QUTstevenbulmer/Unit_EGB220/PCB/ESP32_MotorDriver/ESP32_MotorDriver.png

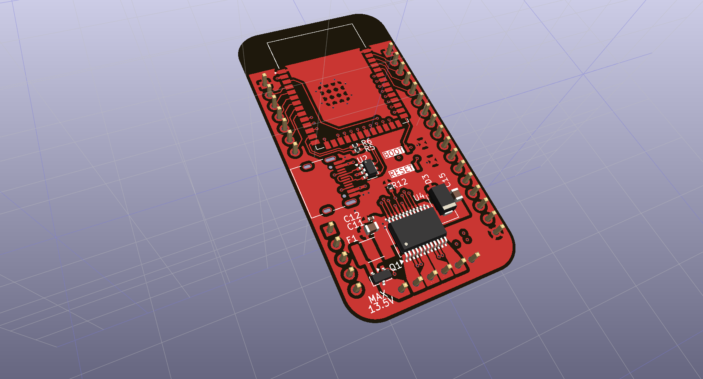
PCB/ESP32_MotorDriver/ESP32_MotorDriver.png
