QUTstevenbulmer/Unit_EGB220/PCB/ESP32_MotorDriver_BOB/ESP32_MotorDriver_BOB.png

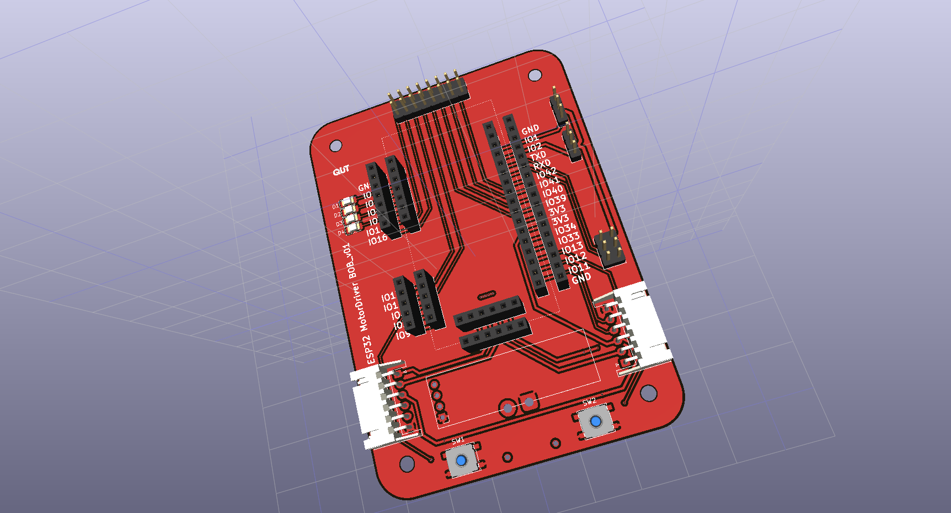
PCB/ESP32_MotorDriver_BOB/ESP32_MotorDriver_BOB.png
