QUTstevenbulmer/Unit_EGB220/PCB/ESP32_MotorDriver/production/bom.csv

Designator | Footprint | Quantity | Value | LCSC Part #
C1, C15, C5, C7 | 0805 | 4 | 10uF
C10, C9 | 0805 | 2 | 22uF
C11 | 0805 | 1 | 10uF | C3902158
C12, C13 | 0402 | 2 | 100nF | C105882
C14, C2, C6, C8 | 0402 | 4 | 100nF
C3 | 0805 | 1 | 10uF | C15850
C4 | 0402 | 1 | 100nF | C15850
D1, D2 | D_SOD-323F | 2 | SS14HE
D3 | D_SMA | 1 | SMAJ12A
F1 | 1812 | 1 | Polyfuse 3A
F2 | 0805 | 1 | Polyfuse 500mA
J1 | USB_C_Receptacle_HRO_TYPE-C-31-M-12 | 1 | USB_C_Receptacle_USB2.0 | C165948
J2 | PinHeader_1x06_P2.54mm_Vertical | 1 | Conn_01x06
J4 | PinHeader_1x05_P2.54mm_Vertical | 1 | Conn_01x05
J6 | PinHeader_1x07_P2.54mm_Vertical | 1 | Conn_01x07
J7 | PinHeader_1x17_P2.54mm_Vertical | 1 | Conn_01x17
L1 | 1008 | 1 | 4.7uH
Q1 | SOT-23 | 1 | AO3407A
R1, R2 | 0402 | 2 | 5k1
R11, R12 | 0402 | 2 | 10k | C851816
R3, R4 | 0402 | 2 | 10k | C100047
R5, R6 | 0402 | 2 | 22R
SW1 | Switch SMD STO | 1 | RESET
SW2 | Switch SMD STO | 1 | BOOT
U1 | XCVR_ESP32-S2-SOLO-N4 | 1 | ESP32-S2-SOLO-N4
U2 | SOT-23-6 | 1 | USBLC6-2SC6
U4 | SSOP-24_5.3x8.2mm_P0.65mm | 1 | TB6612FNG | C141517
U5 | TSOT-23-6 | 1 | AP63203WU
