QUTstevenbulmer/Unit_EGB220/PCB/ESP32_MotorDriver_BOB/production/bom.csv

Designator | Footprint | Quantity | Value | LCSC Part #
C11, C13, C14 | 0402 | 3 | 10uF | C3902158
C12, C15, C16 | 0402 | 3 | 100nF | C105882
D1 | 1206 | 1 | RED
D2 | 1206 | 1 | GREEN
D3 | 1206 | 1 | BLUE
D4 | 1206 | 1 | YELLOW
F1 | 0805 | 1 | Polyfuse 4A | C22368431
J1, J10 | PinSocket_1x07_P2.54mm_Vertical | 2 | Conn_01x07
J11, J2 | PinSocket_1x05_P2.54mm_Vertical | 2 | Conn_01x05
J12, J4 | PinSocket_1x06_P2.54mm_Vertical | 2 | Conn_01x06
J13, J3 | PinSocket_1x17_P2.54mm_Vertical | 2 | Conn_01x17
J14 | PinHeader_2x03_P2.54mm_Vertical | 1 | Conn_02x03_Odd_Even
J15 | PinHeader_2x08_P2.54mm_Vertical | 1 | Conn_02x08_Odd_Even
J5, J6 | JST_XH_S6B-XH-A_1x06_P2.50mm_Horizontal | 2 | Conn_01x06
J7 | AMASS_XT30PW-M_1x02_P2.50mm_Horizontal | 1 | XT30 | C431092
J8, J9 | PinHeader_1x03_P2.54mm_Vertical | 2 | Conn_01x03
Q1 | SOT-23F_TOS | 1 | SSM3J338R_LF | C146352
R1, R2, R3, R4 | 0402 | 4 | 150R
R10 | 0402 | 1 | 10k | C851816
R11, R12, R13, R14 | 0402 | 4 | 10k
R5 | 0402 | 1 | 100k
R6, R7, R8, R9 | 0402 | 4 | 4k7
SW1, SW2 | SW_SPST_EVQP0 | 2 | SW_Push
U1 | SOT-223-3_TabPin2 | 1 | LDL1117S50R
U2 | ER_OLEDM0.91_1x-I2C | 1 | ER_OLEDM0.91_1x-I2C
U3 | SO-8_3.9x4.9mm_P1.27mm | 1 | PCA9306D
U4 | logo_QUT | 1 | ESP32 MotorDriver BOB_v01
