QUTstevenbulmer/Unit_EGB220/PCB/ESP32_MotorDriver_BOB/pcbway_production/2026-10-20-12-05-17/ESP32_MotorDriver_BOB.kicad_pcb_bom.csv

Designator | Quantity | Value | Footprint | Package | MPN | DNP | Mount_Type | Description | KiLib_Generator | LCSC PN | PN_LCSC | PN_Digikey | Manufacturer | PN_Manufacturer | Sim.Pins | MANUFACTURER | LCSC Part #
C11, C13, C14 | 3 | 10uF | C_0805_2012Metric_Pad1.18x1.45mm_HandSolder |  |  |  | smt | Unpolarized capacitor | SMD_2terminal_chip_molded | C3902158
C12, C15, C16, C18, C19, C20 | 6 | 100nF | C_0402_1005Metric_Pad0.74x0.62mm_HandSolder |  |  |  | smt | Unpolarized capacitor | SMD_2terminal_chip_molded | C105882 | C105882 | 311-3342-1-ND | YAGEO | CC0402KRX5R9BB104
C17 | 1 | 10uF 25V | C_0805_2012Metric_Pad1.18x1.45mm_HandSolder |  |  |  | smt | Unpolarized capacitor | SMD_2terminal_chip_molded | C3902158
C3 | 1 | 100nF | C_0603_1608Metric_Pad1.08x0.95mm_HandSolder |  |  |  | smt | Unpolarized capacitor | SMD_2terminal_chip_molded
D1 | 1 | RED | LED_1206_3216Metric_Pad1.42x1.75mm_HandSolder |  |  |  | smt | Light emitting diode | SMD_2terminal_chip_molded |  |  |  |  |  | 1=K 2=A
D2 | 1 | GREEN | LED_1206_3216Metric_Pad1.42x1.75mm_HandSolder |  |  |  | smt | Light emitting diode | SMD_2terminal_chip_molded |  |  |  |  |  | 1=K 2=A
D3 | 1 | BLUE | LED_1206_3216Metric_Pad1.42x1.75mm_HandSolder |  |  |  | smt | Light emitting diode | SMD_2terminal_chip_molded |  |  |  |  |  | 1=K 2=A
D4 | 1 | YELLOW | LED_1206_3216Metric_Pad1.42x1.75mm_HandSolder |  |  |  | smt | Light emitting diode | SMD_2terminal_chip_molded |  |  |  |  |  | 1=K 2=A
D5 | 1 | POWER | LED_0805_2012Metric_Pad1.15x1.40mm_HandSolder |  |  |  | smt | Light emitting diode | SMD_2terminal_chip_molded |  |  |  |  |  | 1=K 2=A
D6 | 1 | BAT54J | D_SOD-323F |  |  |  | smt | 30V 200mA Schottky diode, SOD-323F
F1 | 1 | PTC RESET FUSE 16V 2.5A 1812 | Fuse_1812_4532Metric_Pad1.30x3.40mm_HandSolder |  |  |  | smt |  | SMD_2terminal_chip_molded |  |  | MF-MSMF250/16X-2CT-ND | Bourns Inc. | MF-MSMF250/16X-2
J1, J10 | 2 | Conn_01x07 | PinSocket_1x07_P2.54mm_Vertical |  |  |  | tht | Generic connector, single row, 01x07, script generated (kicad-library-utils/schlib/autogen/connector/) | connector/pin_header_socket
J11, J2 | 2 | Conn_01x05 | PinSocket_1x05_P2.54mm_Vertical |  |  |  | tht | Generic connector, single row, 01x05, script generated (kicad-library-utils/schlib/autogen/connector/) | connector/pin_header_socket
J12, J4 | 2 | Conn_01x06 | PinSocket_1x06_P2.54mm_Vertical |  |  |  | tht | Generic connector, single row, 01x06, script generated (kicad-library-utils/schlib/autogen/connector/) | connector/pin_header_socket
J13, J3 | 2 | Conn_01x17 | PinSocket_1x17_P2.54mm_Vertical |  |  |  | tht | Generic connector, single row, 01x17, script generated (kicad-library-utils/schlib/autogen/connector/) | connector/pin_header_socket
J14 | 1 | Conn_02x03_Odd_Even | PinHeader_2x03_P2.54mm_Vertical |  |  |  | tht | Generic connector, double row, 02x03, odd/even pin numbering scheme (row 1 odd numbers, row 2 even numbers), script generated (kicad-library-utils/schlib/autogen/connector/) | connector/pin_header_socket
J15 | 1 | Conn_02x08_Odd_Even | PinHeader_2x08_P2.54mm_Vertical |  |  |  | tht | Generic connector, double row, 02x08, odd/even pin numbering scheme (row 1 odd numbers, row 2 even numbers), script generated (kicad-library-utils/schlib/autogen/connector/) | connector/pin_header_socket
J5, J6 | 2 | Conn_01x06 | JST_ZH_S6B-ZR-SM4A-TF_1x06-1MP_P1.50mm_Horizontal |  |  |  | smt | Generic connector, single row, 01x06, script generated (kicad-library-utils/schlib/autogen/connector/) | connector/SMD_single_row_plus_mounting_pad |  |  | 455-S6B-ZR-ND |  | S6B-ZR |  | JST Sales America Inc.
J7 | 1 | XT30 | AMASS_XT30PW-M_1x02_P2.50mm_Horizontal |  |  |  | tht | Generic connector, single row, 01x02, script generated |  | C431092 | C431092 |  | Changzhou Amass Elec | XT30PW-M30.G.Y
J8, J9 | 2 | Conn_01x03 | PinHeader_1x03_P2.54mm_Vertical |  |  |  | tht | Generic connector, single row, 01x03, script generated (kicad-library-utils/schlib/autogen/connector/) | connector/pin_header_socket
Q1, Q2 | 2 | AO3407A | SOT-23 |  |  |  | smt | MOSFET P-CH 30V 4.3A SOT23-3L | package/gullwing |  | C15155 | 785-1006-1-ND |  | AO3407A |  | Alpha & Omega Semiconductor
Q3 | 1 | 2N7002 | SOT-23 |  |  |  | smt | 0.115A Id, 60V Vds, N-Channel MOSFET, SOT-23 | package/gullwing
R1, R2, R3, R4 | 4 | 150R | R_0402_1005Metric_Pad0.72x0.64mm_HandSolder |  |  |  | smt | Resistor | SMD_2terminal_chip_molded
R10, R15 | 2 | 33R | R_0402_1005Metric_Pad0.72x0.64mm_HandSolder |  |  |  | smt | Resistor | SMD_2terminal_chip_molded
R11, R12, R13, R14 | 4 | 10k | R_0402_1005Metric_Pad0.72x0.64mm_HandSolder |  |  |  | smt | Resistor | SMD_2terminal_chip_molded
R16 | 1 | 470R | R_0402_1005Metric_Pad0.72x0.64mm_HandSolder |  |  |  | smt | Resistor | SMD_2terminal_chip_molded
R17 | 1 | 10k | R_0603_1608Metric_Pad0.98x0.95mm_HandSolder |  |  |  | smt |  | SMD_2terminal_chip_molded
R18 | 1 | 47k | R_0402_1005Metric_Pad0.72x0.64mm_HandSolder |  |  |  | smt |  | SMD_2terminal_chip_molded
R19, R20 | 2 | 100k | R_0402_1005Metric_Pad0.72x0.64mm_HandSolder |  |  |  | smt |  | SMD_2terminal_chip_molded
R5 | 1 | 200k | R_0402_1005Metric_Pad0.72x0.64mm_HandSolder |  |  |  | smt | Resistor | SMD_2terminal_chip_molded
R6, R7, R8, R9 | 4 | 4k7 | R_0402_1005Metric_Pad0.72x0.64mm_HandSolder |  |  |  | smt | Resistor | SMD_2terminal_chip_molded
SW1, SW2 | 2 | SW_Push | SW_SPST_EVQP0 |  |  |  | smt | Push button switch, generic, two pins |  |  |  | P12966SCT-ND
SW3 | 1 | ON/OFF | SW_SPST_EVQP0 |  |  |  | smt | Push button switch, generic, two pins |  |  |  | P12966SCT-ND
U1 | 1 | LDL1117S50R | SOT-223-3_TabPin2 |  |  |  | smt | Linear Voltage Regulator IC Positive Fixed 1 Output 1.2A SOT-223 |  |  |  | 497-17240-1-ND | STMicroelectronics | LDL1117S50R
U2 | 1 | ER_OLEDM0.91_1x-I2C | ER_OLEDM0.91_1x-I2C |  |  |  | tht | SSD1306 OLED module, 0.91 inch, 128x32, I2C
U3 | 1 | PCA9306DCUR | VSSOP-8_3x3mm_P0.65mm |  |  |  | smt | Dual bidirectional I2C Bus and SMBus voltage level translator, VSSOP-8 | package/gullwing |  |  | 296-17988-1-ND | Texas Instruments | PCA9306DCUR
U4 | 1 | ESP32 MotorDriver BOB_v02 | logo_QUT |  |  |  | tht
U5 | 1 | MAX16054 | SOT-23-6 |  |  |  | smt |  | package/gullwing |  |  | MAX16054AZT+TCT-ND | Analog Devices Inc./Maxim Integrated | MAX16054AZT+T |  |  | C79401
U6 | 1 | TLV70433_SOT23-5 | SOT-23-5 |  |  |  | smt | 150mA Low Dropout Voltage Regulator, 24Vin, Fixed Output 3.3V, SOT-23-5 | package/gullwing |  |  | 296-39285-1-ND | Texas Instruments | TLV70433DBVR
