QUTstevenbulmer/Unit_EGB220/PCB/ESP32_MotorDriver/pcbway_production/2026-10-12-10-22-03/ESP32_MotorDriver.kicad_pcb_bom.csv

Designator | Quantity | Value | Footprint | Package | MPN | DNP | Mount_Type | Description | KiLib_Generator | LCSC PN | LCSC Part # | Manufacturer | PN_Manufacturer | PN_Digikey | MANUFACTURER | LCSC_PN | PARTREV | STANDARD | MAXIMUM_PACKAGE_HEIGHT | PN_LCSC
C1, C11, C15, C3, C5, C7 | 6 | 10uF | C_0805_2012Metric_Pad1.18x1.45mm_HandSolder |  |  |  | smt | Unpolarized capacitor | SMD_2terminal_chip_molded | C3902158 | C15850
C10, C9 | 2 | 22uF | C_0805_2012Metric_Pad1.18x1.45mm_HandSolder |  |  |  | smt | Unpolarized capacitor | SMD_2terminal_chip_molded
C12, C13, C14, C2, C4, C6, C8 | 7 | 100nF | C_0402_1005Metric_Pad0.74x0.62mm_HandSolder |  |  |  | smt | Unpolarized capacitor | SMD_2terminal_chip_molded | C105882 | C15850 | YAGEO
D1, D2 | 2 | SS14HE | D_SOD-323F |  |  |  | smt | Schottky diode |  |  |  |  | SS14HE | SS14HECT-ND | Onsemi
D3 | 1 | SMAJ12A | D_SMA |  |  |  | smt | 400W unidirectional Transient Voltage Suppressor, 12.0Vr, SMA(DO-214AC)
F1 | 1 | Polyfuse 3A | Fuse_1812_4532Metric_Pad1.30x3.40mm_HandSolder |  |  |  | smt | Resettable fuse, polymeric positive temperature coefficient | SMD_2terminal_chip_molded
F2 | 1 | Polyfuse 500mA | Fuse_0805_2012Metric_Pad1.15x1.40mm_HandSolder |  |  |  | smt | Resettable fuse, polymeric positive temperature coefficient | SMD_2terminal_chip_molded
J1 | 1 | USB_C_Receptacle_USB2.0 | USB_C_Receptacle_HRO_TYPE-C-31-M-12 |  |  |  | smt |  |  |  | C165948
J2 | 1 | Conn_01x06 | PinHeader_1x06_P2.54mm_Vertical |  |  |  | tht | Generic connector, single row, 01x06, script generated (kicad-library-utils/schlib/autogen/connector/) | connector/pin_header_socket
J4 | 1 | Conn_01x05 | PinHeader_1x05_P2.54mm_Vertical |  |  |  | tht | Generic connector, single row, 01x05, script generated (kicad-library-utils/schlib/autogen/connector/) | connector/pin_header_socket
J6 | 1 | Conn_01x07 | PinHeader_1x07_P2.54mm_Vertical |  |  |  | tht | Generic connector, single row, 01x07, script generated (kicad-library-utils/schlib/autogen/connector/) | connector/pin_header_socket
J7 | 1 | Conn_01x17 | PinHeader_1x17_P2.54mm_Vertical |  |  |  | tht | Generic connector, single row, 01x17, script generated (kicad-library-utils/schlib/autogen/connector/) | connector/pin_header_socket
L1 | 1 | 4.7uH | L_1008_2520Metric_Pad1.43x2.20mm_HandSolder |  |  |  | smt | Inductor, small symbol | SMD_2terminal_chip_molded |  |  | Murata Electronics | DFE252012F-4R7M=P2 | 490-13051-1-ND
Q1 | 1 | AO3407A | SOT-23 |  |  |  | smt | MOSFET P-CH 30V 4.3A SOT23-3L | package/gullwing |  |  | Alpha & Omega Semiconductor Inc. | AO3407A | 785-1006-1-ND
R1, R2 | 2 | 5k1 | R_0402_1005Metric_Pad0.72x0.64mm_HandSolder |  |  |  | smt | Resistor | SMD_2terminal_chip_molded
R11, R12, R3, R4 | 4 | 10k | R_0402_1005Metric_Pad0.72x0.64mm_HandSolder |  |  |  | smt |  | SMD_2terminal_chip_molded | C851816 | C100047 | YAGEO
R5, R6 | 2 | 22R | R_0402_1005Metric_Pad0.72x0.64mm_HandSolder |  |  |  | smt | Resistor, small symbol | SMD_2terminal_chip_molded
SW1 | 1 | RESET | Switch SMD STO |  |  |  | smt |  |  |  |  |  | R-667995 | 2508-R-667995CT-ND
SW2 | 1 | BOOT | Switch SMD STO |  |  |  | smt |  |  |  |  | Mitsumi | R-667995 | 2508-R-667995CT-ND |  | C25168823
U1 | 1 | ESP32-S2-SOLO-N4 | XCVR_ESP32-S2-SOLO-N4 |  |  |  | smt |  |  |  |  |  |  | 1965-ESP32-S2-SOLO-N4CT-ND | Espressif Systems |  | 1.6 | Manufacturer Recommendations | 3.25 mm
U2 | 1 | USBLC6-2SC6 | SOT-23-6 |  |  |  | smt | Very low capacitance ESD protection diode, 2 data-line, SOT-23-6 | package/gullwing
U4 | 1 | TB6612FNG | SSOP-24_5.3x8.2mm_P0.65mm |  |  |  | smt | Driver IC for Dual DC motor, SSOP-24 | package/gullwing | C141517 |  | Toshiba Semiconductor and Storage | TB6612FNG,C,8,EL | TB6612FNGC8ELCT-ND |  |  |  |  |  | C141517
U5 | 1 | AP63203WU | TSOT-23-6 |  |  |  | smt | 2A, 1.1MHz Buck DC/DC Converter, fixed 3.3V output voltage, TSOT-23-6 | package/gullwing
