QUTstevenbulmer/Unit_EGB220/PCB/Build_2027.xlsx

Sheet: Config
1 USD = | 1.43 | AUD
 |  |  |  |  |  | Parts |  | Total
 |  | Quantities | Bare PCB | Assembly | Shipping | Digikey | LCSC | Digikey | LCSC
MotorDriver |  | 350 | 6 | 9 | 2 | 11.7241 | 6.302725 | 10053.435 | 8155.95375
MotorDriver BOB |  | 100 | 6 | 9 | 2 | 0.9704 | 0.8053 | 1797.04 | 1780.53
 |  |  |  |  |  |  |  | 11850.475 | 9936.48375 | TOTALS

Sheet: Build_2027
 |  |  |  |  | Digikey |  | LCSC |  | ESP32 Motor Driver |  |  |  | ESP32 Motor Driver BOB
Description | Value | Footprint | Manufacturer | PN_Manufacturer | PN_Digikey | Price Each | PN_LCSC | Price Each | References | Quantity | Cost_Digikey | Cost_LCSC | References | Quantity | Cost_Digikey | Cost_LCSC
Capacitor | 10uF | 0805 | Samsung Electro-Mechanics | CL21A106KAYNNNE | 1276-2891-1-ND | 0.1112 | C15850 | 0.0695 | C1,C3,C5,C7,C11,C15 | 6 | 0.6672 | 0.417 |  | 3 | 0.3336 | 0.2085
Capacitor | 100nF | 0402 | Murata | GRM155R71H104KE14D | 490-10700-1-ND | 0.0208 | C77020 | 0.0091 | C2,C4,C6,C8,C12,C13,C14 | 7 | 0.1456 | 0.0637 |  | 3 | 0.0624 | 0.0273
Capacitor | 22uF | 0805 | Samsung Electro-Mechanics | CL21A226MAQNNNE | 1276-2908-1-ND | 0.31 | C45783 | 0.2394 | C9,C10 | 2 | 0.62 | 0.4788 |  |  | 0 | 0
Diode | SS14HE | SOD-323F | Onsemi | SS14HE | SS14HECT-ND | 0.3358 | C894424 | 0.1724 | D1,D2 | 2 | 0.6716 | 0.3448 |  |  | 0 | 0
Diode | SMAJ12A | :D_SMA | Littelfuse | SMAJ12A | SMAJ12ALFCT-ND | 0.28 | C148213 | 0.089 | D3 | 1 | 0.28 | 0.089 |  |  | 0 | 0
Fuse | Polyfuse 3A | 1812 | Bourns | MF-MSMF250/16X-2 | MF-MSMF250-16X-2CT-ND | 0.5447 | C210838 | 0.1557 | F1 | 1 | 0.5447 | 0.1557 |  |  | 0 | 0
Fuse | Polyfuse 500mA | 0805 | Littelfuse | 0805L050WR | F2772CT-ND | 0.556 | C207022 | 0.0924 | F2 | 1 | 0.556 | 0.0924 |  |  | 0 | 0
Connector | USB_C_Receptacle_USB2.0 | HRO_TYPE-C-31-M-12 |  |  |  |  | C165948 | 0.1483 | J1 | 1 | 0 | 0.1483 |  |  | 0 | 0
Connector | Conn_01x06 | 1x06_P2.54mm_Vertical |  |  |  |  |  |  | J2 | 1 | 0 | 0 |  |  | 0 | 0
Connector | Conn_01x05 | 1x05_P2.54mm_Vertical |  |  |  |  |  |  | J4 | 1 | 0 | 0 |  |  | 0 | 0
Connector | Conn_01x07 | 1x07_P2.54mm_Vertical |  |  |  |  |  |  | J6 | 1 | 0 | 0 |  |  | 0 | 0
Connector | Conn_01x17 | 1x17_P2.54mm_Vertical |  |  |  |  |  |  | J7 | 1 | 0 | 0 |  |  | 0 | 0
Connector | XT30 | AMASS_XT30PW-M | Amass | XT30PW-M30.G.Y |  |  | C431092 | 0.2577 |  | 0 | 0 | 0 |  | 1 | 0 | 0.2577
Inductor | 4.7uH | 1008 | Murata | DFE252012F-4R7M=P2 | 490-13051-1-ND | 0.2641 | C668313 | 0.1177 | L1 | 1 | 0.2641 | 0.1177 |  |  | 0 | 0
MOSFET | AO3407A | SOT-23 | Alpha & Omega Semiconductor | AO3407A | 785-1006-1-ND | 0.2975 | C15155 | 0.0782 | Q1 | 1 | 0.2975 | 0.0782 |  | 1 | 0.2975 | 0.0782
Resistor | 5k1 | 0402 | Yageo | RC0402FR-075K1L | 311-5.10KLRCT-ND | 0.0141 | C25905 | 0.0024 | R1,R2 | 2 | 0.0282 | 0.0048 |  |  | 0 | 0
Resistor | 10k | 0402 | Yageo | RC0402FR-0710KL | 311-10.0KLRCT-ND | 0.0141 | C25744 | 0.0034 | R3,R4,R11,R12 | 4 | 0.0564 | 0.0136 |  | 4 | 0.0564 | 0.0136
Resistor | 22R | 0402 | Yageo | RC0402FR-0722RL | 311-22.0LRCT-ND | 0.015 | C25092 | 0.0028 | R5,R6 | 2 | 0.03 | 0.0056 |  |  | 0 | 0
Switch | RESET | SMD STO | Mitsumi | R-667995 | 2508-R-667995CT-ND | 0.2052 | C4364645 | 0.3262 | SW1 | 1 | 0.2052 | 0.3262 |  |  | 0 | 0
Switch | BOOT | SMD STO | Mitsumi | R-667995 | 2508-R-667995CT-ND | 0.2052 | C4364645 | 0.3262 | SW2 | 1 | 0.2052 | 0.3262 |  |  | 0 | 0
Module | ESP32-S2-SOLO-N4 | XCVR_ESP32-S2-SOLO-N4 | Espressif Systems | ESP32-S2-SOLO-N4 | 1965-ESP32-S2-SOLO-N4CT-ND | 4.3387 |  |  | U1 | 1 | 4.3387 | 0 |  |  | 0 | 0
IC | USBLC6-2SC6 | :SOT-23-6 | STMicroelectronics | USBLC6-2SC6 | 497-5235-1-ND | 0.304 | C7519 | 0.1375 | U2 | 1 | 0.304 | 0.1375 |  |  | 0 | 0
IC | TB6612FNG | SSOP-24_5.3x8.2mm_P0.65mm | Toshiba | TB6612FNG,C,8,EL | TB6612FNGC8ELCT-ND | 1.7786 | C141517 | 0.7547 | U4 | 1 | 1.7786 | 0.7547 |  |  | 0 | 0
IC | AP63203WU | TSOT-23-6 | Diodes Incorporated | AP63203WU-7 | AP63203WU-7DICT-ND | 0.7311 | C780769 | 0.8533 | U5 | 1 | 0.7311 | 0.8533 |  |  | 0 | 0
IC | LDL1117S50R | SOT-223-3 | STMicroelectronics | LDL1117S50R | 497-17240-1-ND | 0.2205 | C970558 (https://www.lcsc.com/product-detail/C970558.html?s_z=n_q_LDL1117S50R) | 0.22 |  | 0 | 0 | 0 |  | 1 | 0.2205 | 0.22
LEDs |  |  |  |  |  |  |  |  |  | 0 | 0 | 0 |  | 4 | 0 | 0
 |  |  |  |  |  |  |  |  | Total |  | 11.7241 | 4.4075 | Total |  | 0.9704 | 0.8053
 |  |  |  |  |  |  |  |  |  |  | AUD | USD |  |  | AUD | USD
 |  |  |  |  |  |  |  |  |  |  | 11.7241 | 6.302725 |  |  | 0.9704 | 1.151579
 |  |  |  |  |  |  |  |  |  |  | AUD | AUD |  |  | AUD | AUD
