QUTstevenbulmer/Unit_EGB220/PCB/ESP32_MotorDriver_BOB/ESP32_MotorDriver_BOB.pdf

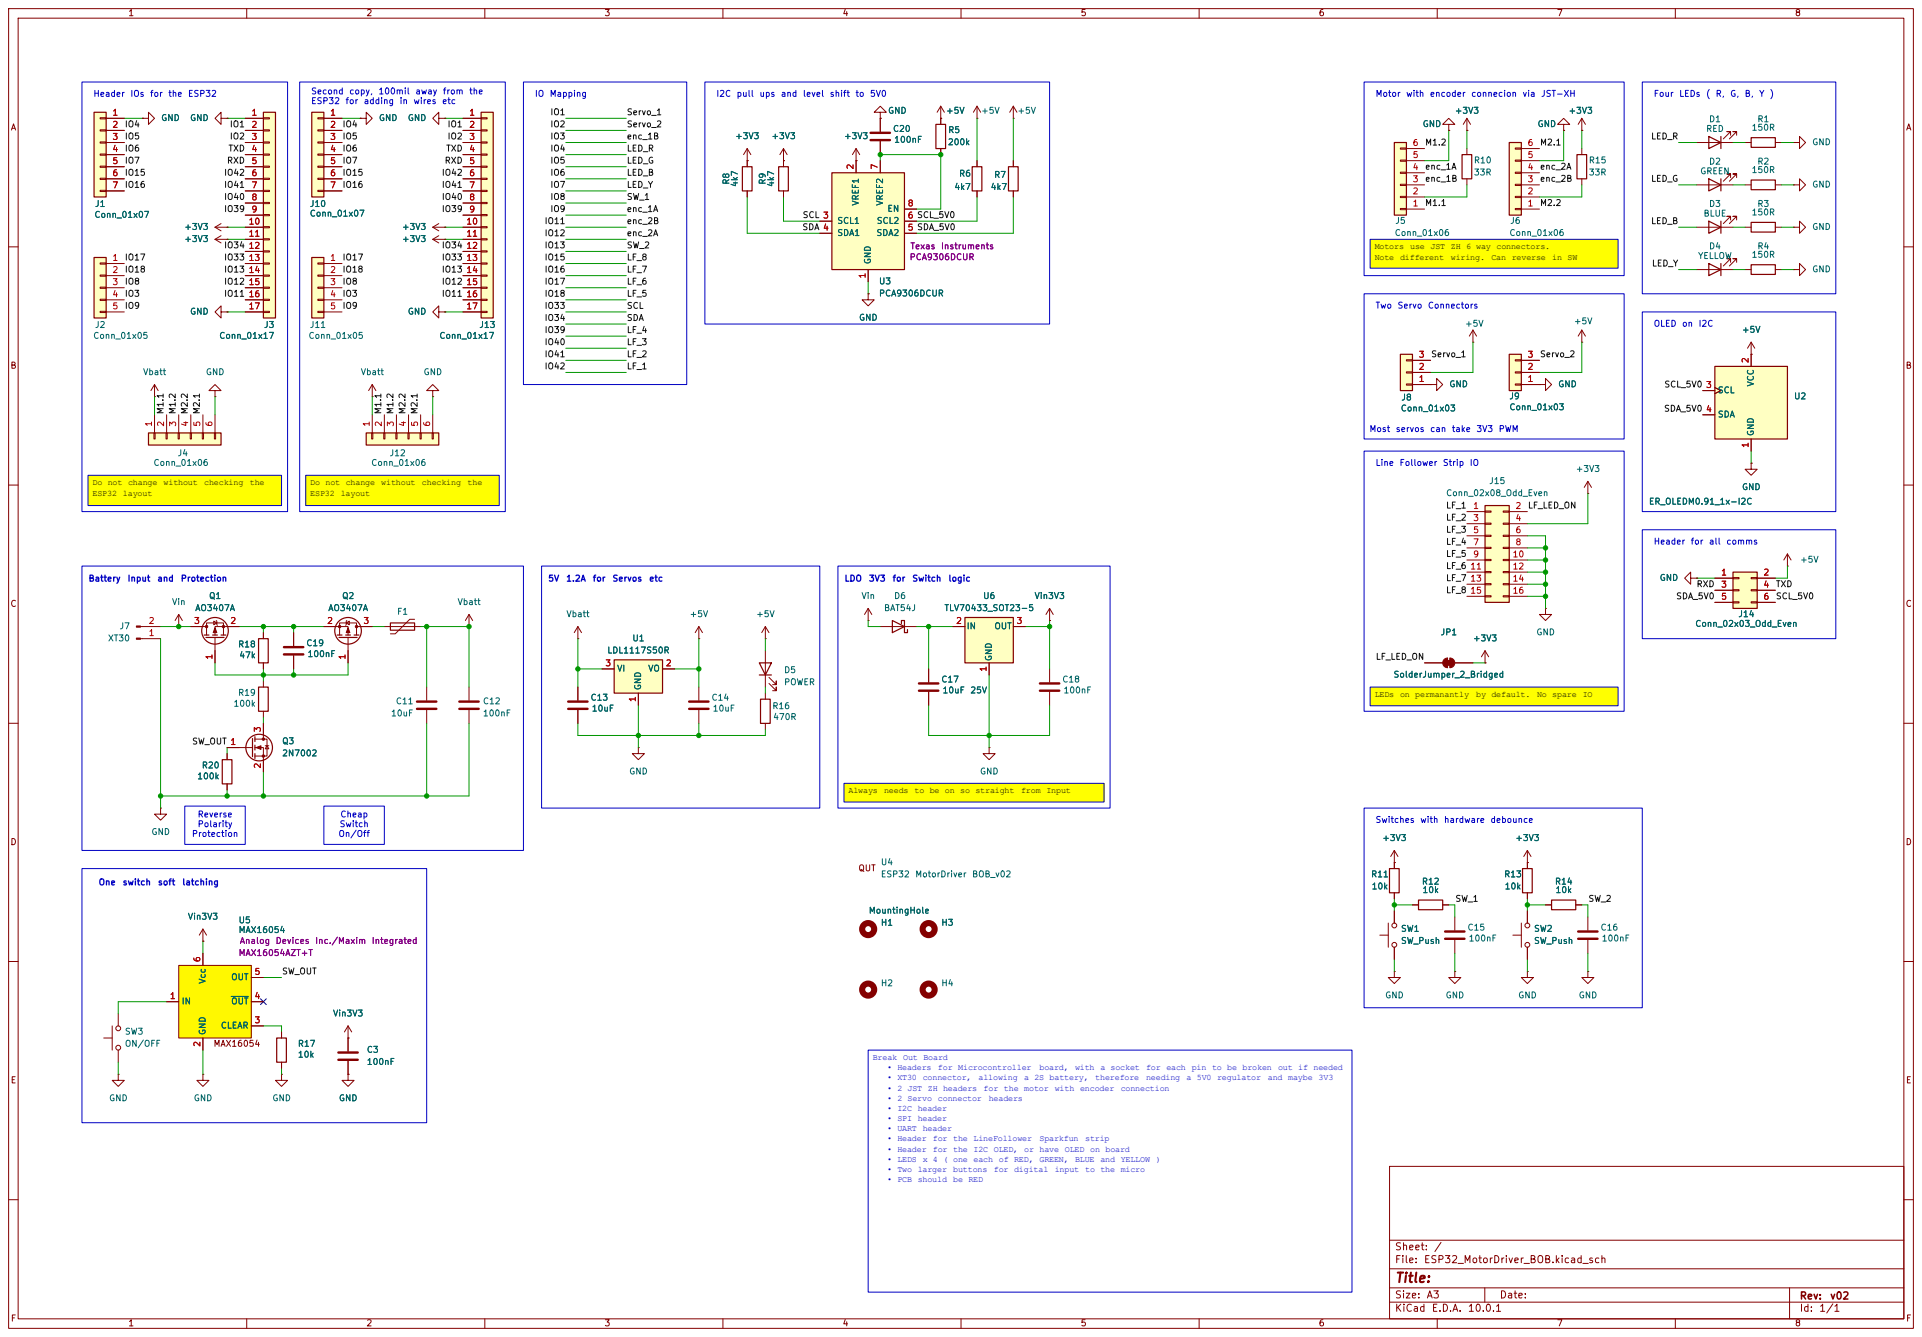
[picture p3: page 1]

Motor with encoder connecion via JST-XH
J5Conn_01x06 GND

Motors use JST ZH 6 way connectors.
Note different wiring. Can reverse in SW

Line Follower Strip IO

Do not change without checking the
ESP32 layout

Header for all comms Battery Input and Protection

SolderJumper_2_Bridged +3V3 R17
Always needs to be on so straight from Input Reverse Polarity Protection

2 CLEAR 3 OUT 4 OUT 5 Vcc 6 U5MAX16054

Analog Devices Inc./Maxim Integrated MAX16054AZT+T

2 CLEAR 3 OUT 4 OUT 5 Vcc 6 GND

Break Out Board
• Headers for Microcontroller board, with a socket for each pin to be broken out if needed
• XT30 connector, allowing a 2S battery, therefore needing a 5V0 regulator and maybe 3V3
• 2 JST ZH headers for the motor with encoder connection
• 2 Servo connector headers
• I2C header
• SPI header
• UART header
• Header for the LineFollower Sparkfun strip
• Header for the I2C OLED, or have OLED on board
• LEDS x 4 ( one each of RED, GREEN, BLUE and YELLOW )
• Two larger buttons for digital input to the micro
• PCB should be RED

Size: A3 | Rev: v02 | F Date:
KiCad E.D.A. 10.0.1 | Id: 1/1
