QUTstevenbulmer/Unit_EGB220/PCB/ESP32_MotorDriver/ESP32_MotorDriver.pdf

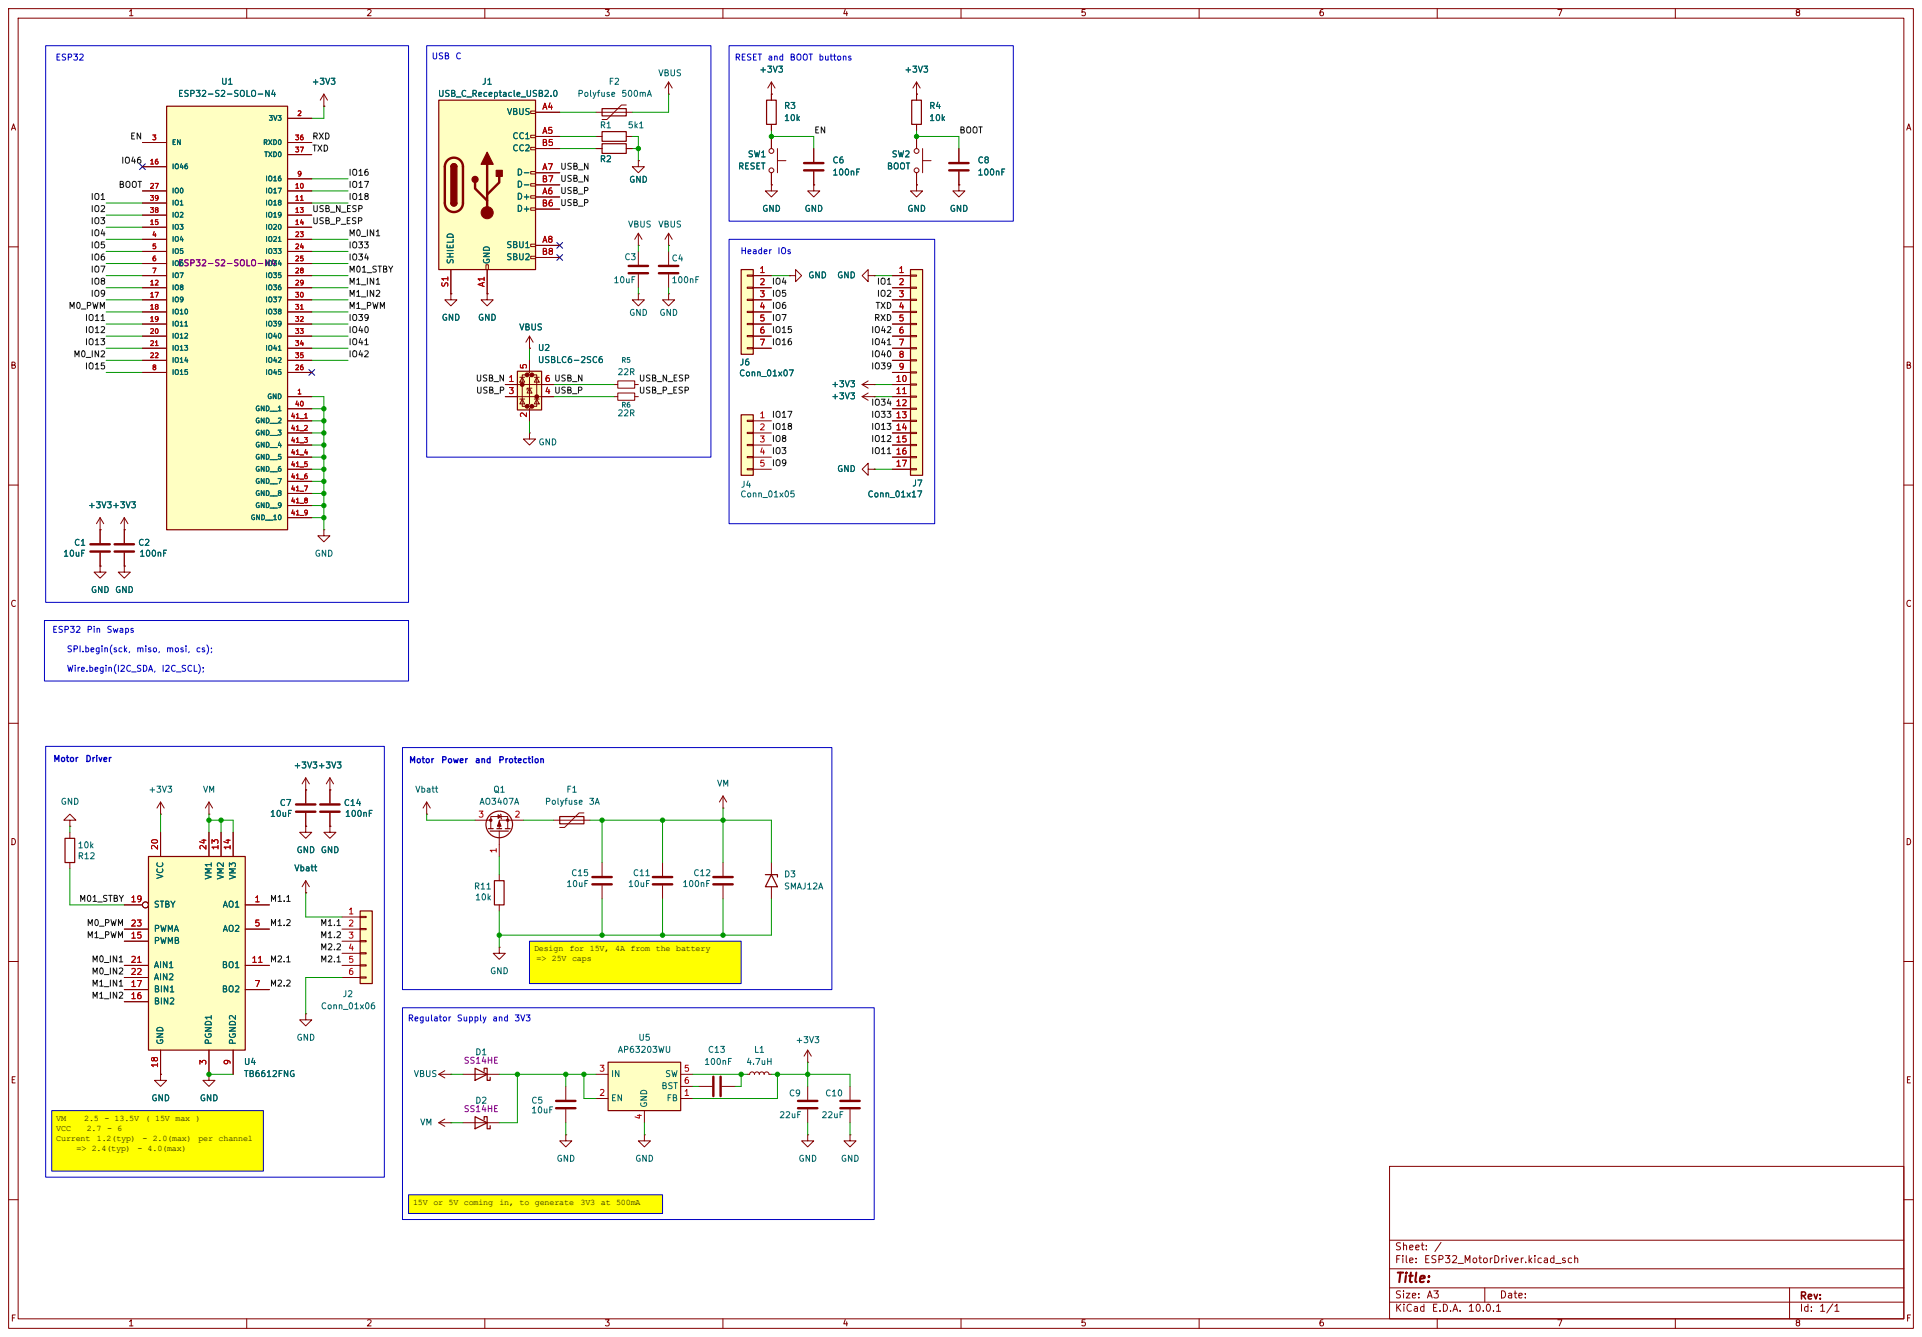
[picture p4: page 1]

SPI.begin(sck, miso, mosi, cs);

Design for 15V, 4A from the battery
=> 25V caps

Current 1.2(typ) - 2.0(max) per channel

15V or 5V coming in, to generate 3V3 at 500mA

Size: A3 | Rev:
KiCad E.D.A. 10.0.1 | Id: 1/1
