QUTstevenbulmer/Unit_EGB220/PCB/ESP32_MotorDriver/ESP32_MotorDriver.kicad_pcb

## KiCad design PCB/ESP32_MotorDriver/ESP32_MotorDriver.kicad_pcb (2026-10-28)

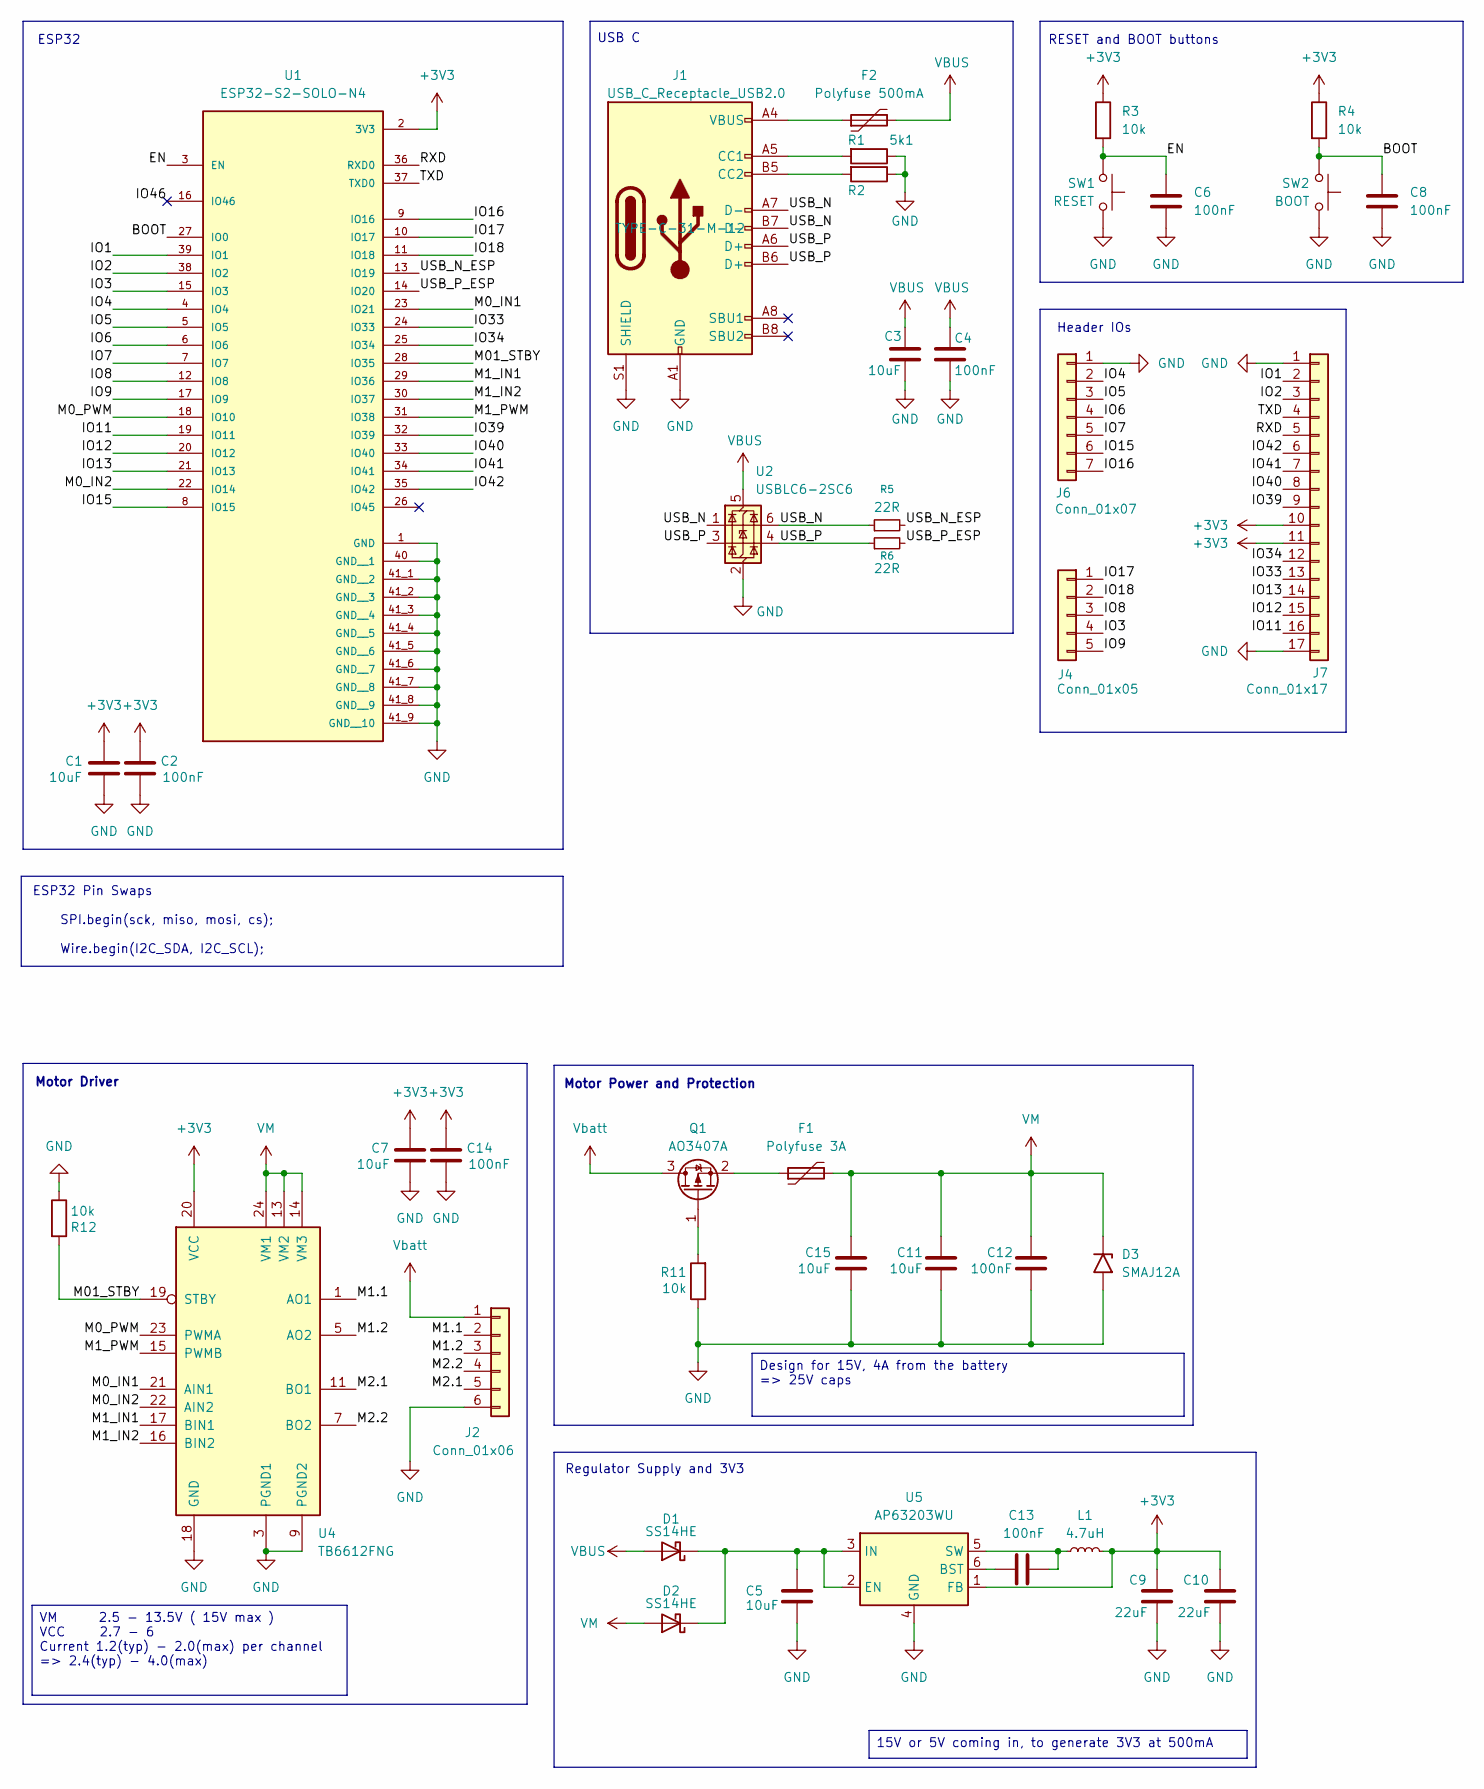
[picture p5: schematic ESP32_MotorDriver.kicad_sch]

Parts:
C1, C5, C7, C15: 10uF; C_0805_2012Metric_Pad1.18x1.45mm_HandSolder
C2, C6, C8, C14: 100nF; C_0402_1005Metric_Pad0.74x0.62mm_HandSolder
C3: 10uF; C_0805_2012Metric_Pad1.18x1.45mm_HandSolder; LCSC Part # C15850
C4: 100nF; C_0402_1005Metric_Pad0.74x0.62mm_HandSolder; LCSC Part # C15850
C9, C10: 22uF; C_0805_2012Metric_Pad1.18x1.45mm_HandSolder
C11: 10uF; C_0805_2012Metric_Pad1.18x1.45mm_HandSolder; LCSC PN C3902158
C12, C13: 100nF; C_0402_1005Metric_Pad0.74x0.62mm_HandSolder; LCSC PN C105882
D1, D2: SS14HE; D_SOD-323HE_SS14HE
D3: SMAJ12A; D_SMA
F1: Polyfuse 3A; Fuse_1812_4532Metric_Pad1.30x3.40mm_HandSolder
F2: Polyfuse 500mA; Fuse_0805_2012Metric_Pad1.15x1.40mm_HandSolder
J1: USB_C_Receptacle_USB2.0; USB_C_Receptacle_HRO_TYPE-C-31-M-12; LCSC Part # C165948
J2: Conn_01x06; PinHeader_1x06_P2.54mm_Vertical
J4: Conn_01x05; PinHeader_1x05_P2.54mm_Vertical
J6: Conn_01x07; PinHeader_1x07_P2.54mm_Vertical
J7: Conn_01x17; PinHeader_1x17_P2.54mm_Vertical
L1: 4.7uH; L_1008_2520Metric_Pad1.43x2.20mm_HandSolder
Q1: AO3407A; SOT-23
R1, R2: 5k1; R_0402_1005Metric_Pad0.72x0.64mm_HandSolder
R3, R4: 10k; R_0402_1005Metric_Pad0.72x0.64mm_HandSolder; LCSC Part # C100047
R5, R6: 22R; R_0402_1005Metric_Pad0.72x0.64mm_HandSolder
R11, R12: 10k; R_0402_1005Metric_Pad0.72x0.64mm_HandSolder; LCSC PN C851816
SW1: RESET; Switch SMD STO
SW2: BOOT; Switch SMD STO; LCSC_PN C25168823
U1: ESP32-S2-SOLO-N4; XCVR_ESP32-S2-SOLO-N4; PARTREV 1.6
U2: USBLC6-2SC6; SOT-23-6
U4: TB6612FNG; SSOP-24_5.3x8.2mm_P0.65mm; LCSC PN C141517
U5: AP63203WU; TSOT-23-6

Connections:
+3V3: C1.1, C2.1, C7.1, C9.1, C10.1, C14.1, J7.10, J7.11, L1.2, R3.1, R4.1, U1.2 (3V3), U4.20 (VCC), U5.1 (FB)
/BOOT: C8.1, R4.2, SW2.1, U1.27 (IO0)
/EN: C6.1, R3.2, SW1.1, U1.3 (EN)
/IO1: J7.2, U1.39 (IO1)
/IO2: J7.3, U1.38 (IO2)
/IO3: J4.4, U1.15 (IO3)
/IO4: J6.2, U1.4 (IO4)
/IO5: J6.3, U1.5 (IO5)
/IO6: J6.4, U1.6 (IO6)
/IO7: J6.5, U1.7 (IO7)
/IO8: J4.3, U1.12 (IO8)
/IO9: J4.5, U1.17 (IO9)
/IO11: J7.16, U1.19 (IO11)
/IO12: J7.15, U1.20 (IO12)
/IO13: J7.14, U1.21 (IO13)
/IO15: J6.6, U1.8 (IO15)
/IO16: J6.7, U1.9 (IO16)
/IO17: J4.1, U1.10 (IO17)
/IO18: J4.2, U1.11 (IO18)
/IO33: J7.13, U1.24 (IO33)
/IO34: J7.12, U1.25 (IO34)
/IO39: J7.9, U1.32 (IO39)
/IO40: J7.8, U1.33 (IO40)
/IO41: J7.7, U1.34 (IO41)
/IO42: J7.6, U1.35 (IO42)
/IO46: U1.16 (IO46)
/M0_IN1: U1.23 (IO21), U4.21 (AIN1)
/M0_IN2: U1.22 (IO14), U4.22 (AIN2)
/M0_PWM: U1.18 (IO10), U4.23 (PWMA)
/M1.1: J2.2, U4.1 (AO1), U4.2 (AO1)
/M1.2: J2.3, U4.5 (AO2), U4.6 (AO2)
/M1_IN1: U1.29 (IO36), U4.17 (BIN1)
/M1_IN2: U1.30 (IO37), U4.16 (BIN2)
/M1_PWM: U1.31 (IO38), U4.15 (PWMB)
/M01_STBY: R12.2, U1.28 (IO35), U4.19 (STBY)
/M2.1: J2.5, U4.11 (BO1), U4.12 (BO1)
/M2.2: J2.4, U4.7 (BO2), U4.8 (BO2)
/RXD: J7.5, U1.36 (RXD0)
/TXD: J7.4, U1.37 (TXD0)
/USB_N: J1.A7 (D-), J1.B7 (D-), R5.1, U2.1 (I/O1), U2.6 (I/O1)
/USB_N_ESP: R5.2, U1.13 (IO19)
/USB_P: J1.A6 (D+), J1.B6 (D+), R6.1, U2.3 (I/O2), U2.4 (I/O2)
/USB_P_ESP: R6.2, U1.14 (IO20)
GND: C1.2, C2.2, C3.2, C4.2, C5.2, C6.2, C7.2, C8.2, C9.2, C10.2, C11.2, C12.2, C14.2, C15.2, D3.2 (A2), J1.A1 (GND), J1.A12 (GND), J1.B1 (GND), J1.B12 (GND), J1.S1 (SHIELD), J2.6, J6.1, J7.1, J7.17, R1.1, R2.1, R11.1, R12.1, SW1.2, SW2.2, U1.1 (GND), U1.40 (GND__1), U1.41_1 (GND__2), U1.41_2 (GND__3), U1.41_3 (GND__4), U1.41_4 (GND__5), U1.41_5 (GND__6), U1.41_6 (GND__7), U1.41_7 (GND__8), U1.41_8 (GND__9), U1.41_9 (GND__10), U2.2 (GND), U4.3 (PGND1), U4.4 (PGND1), U4.9 (PGND2), U4.10 (PGND2), U4.18 (GND), U5.4 (GND)
unnamed: C5.1, D1.1 (K), D2.1 (K), U5.2 (EN), U5.3 (IN)
unnamed: F2.1, J1.A4 (VBUS), J1.A9 (VBUS), J1.B4 (VBUS), J1.B9 (VBUS)
unnamed: J1.A5 (CC1), R1.2
unnamed: J1.B5 (CC2), R2.2
unnamed: Q1.1 (G), R11.2
unnamed: F1.1, Q1.2 (S)
unnamed: C13.1, U5.6 (BST)
unnamed: C13.2, L1.1, U5.5 (SW)
VBUS: C3.1, C4.1, D1.2 (A), F2.2, U2.5 (VBUS)
VM: C11.1, C12.1, C15.1, D2.2 (A), D3.1 (A1), F1.2, U4.13 (VM2), U4.14 (VM3), U4.24 (VM1)
Vbatt: J2.1, Q1.3 (D)

Notes on the sheet:
ESP32 Pin Swaps SPI.begin(sck, miso, mosi, cs); Wire.begin(I2C_SDA, I2C_SCL);
Regulator Supply and 3V3
Header IOs
Motor Driver
RESET and BOOT buttons
USB C
ESP32
Motor Power and Protection
15V or 5V coming in, to generate 3V3 at 500mA
Design for 15V, 4A from the battery => 25V caps
VM 2.5 - 13.5V ( 15V max ) VCC 2.7 - 6 Current 1.2(typ) - 2.0(max) per channel => 2.4(typ) - 4.0(max)

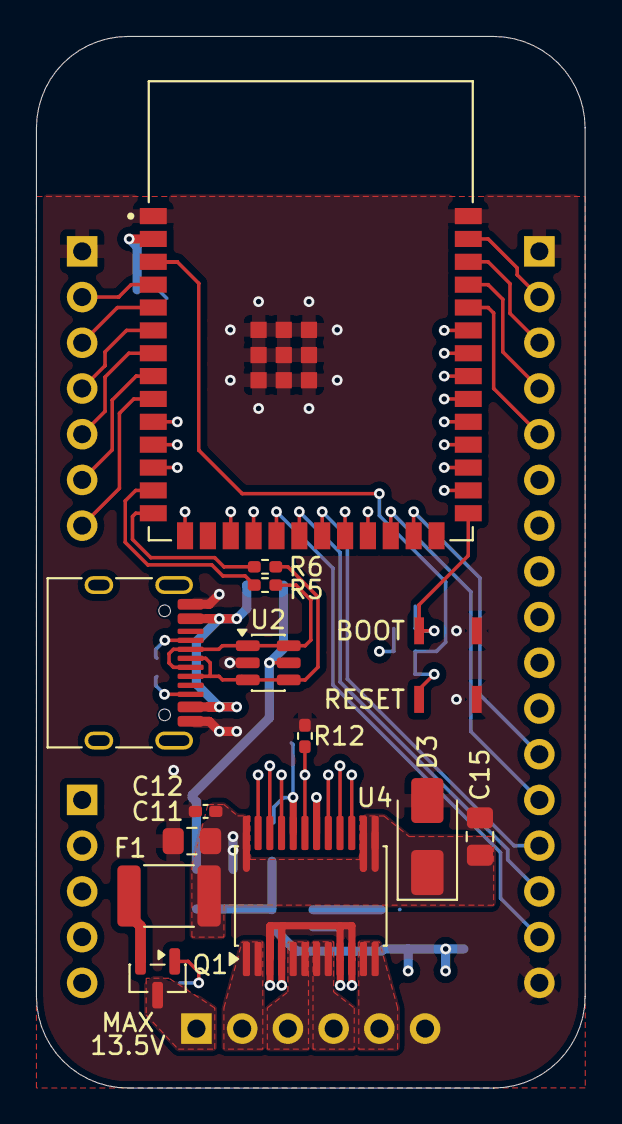
[picture p6: board ESP32_MotorDriver.kicad_pcb from above]

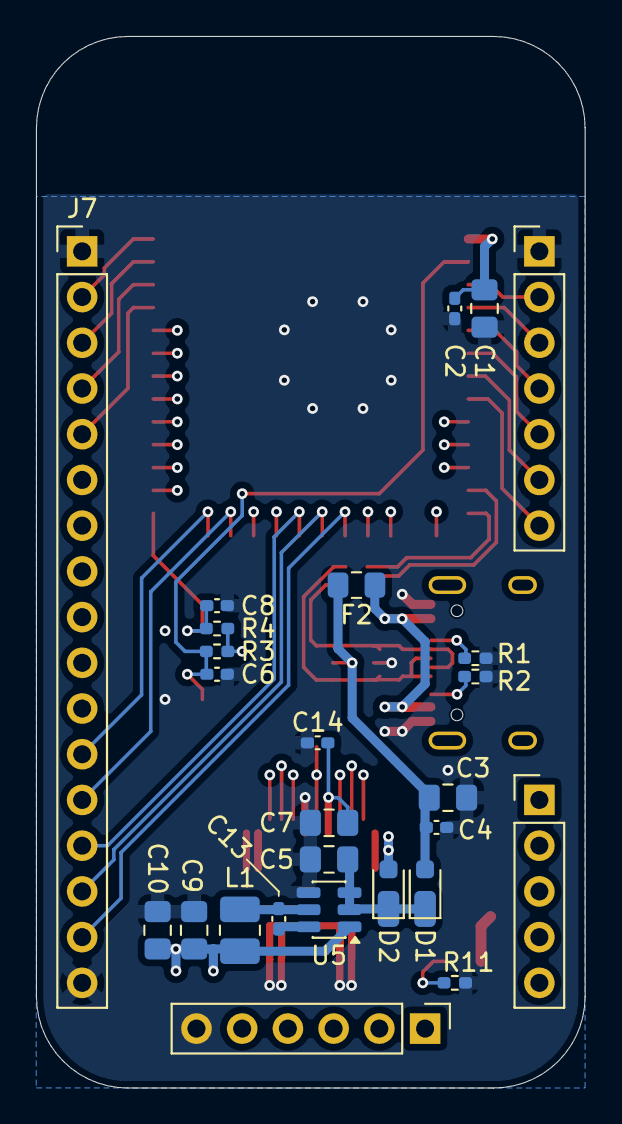
[picture p7: board ESP32_MotorDriver.kicad_pcb from below]

Board: 4 copper layers, 30.5 x 58.4 mm, 41 parts (26 on the bottom side), 54 nets.
