QUTstevenbulmer/Unit_EGB220/PCB/ESP32_MotorDriver_BOB/ESP32_MotorDriver_BOB.kicad_pcb

## KiCad design PCB/ESP32_MotorDriver_BOB/ESP32_MotorDriver_BOB.kicad_pcb (2026-10-28)

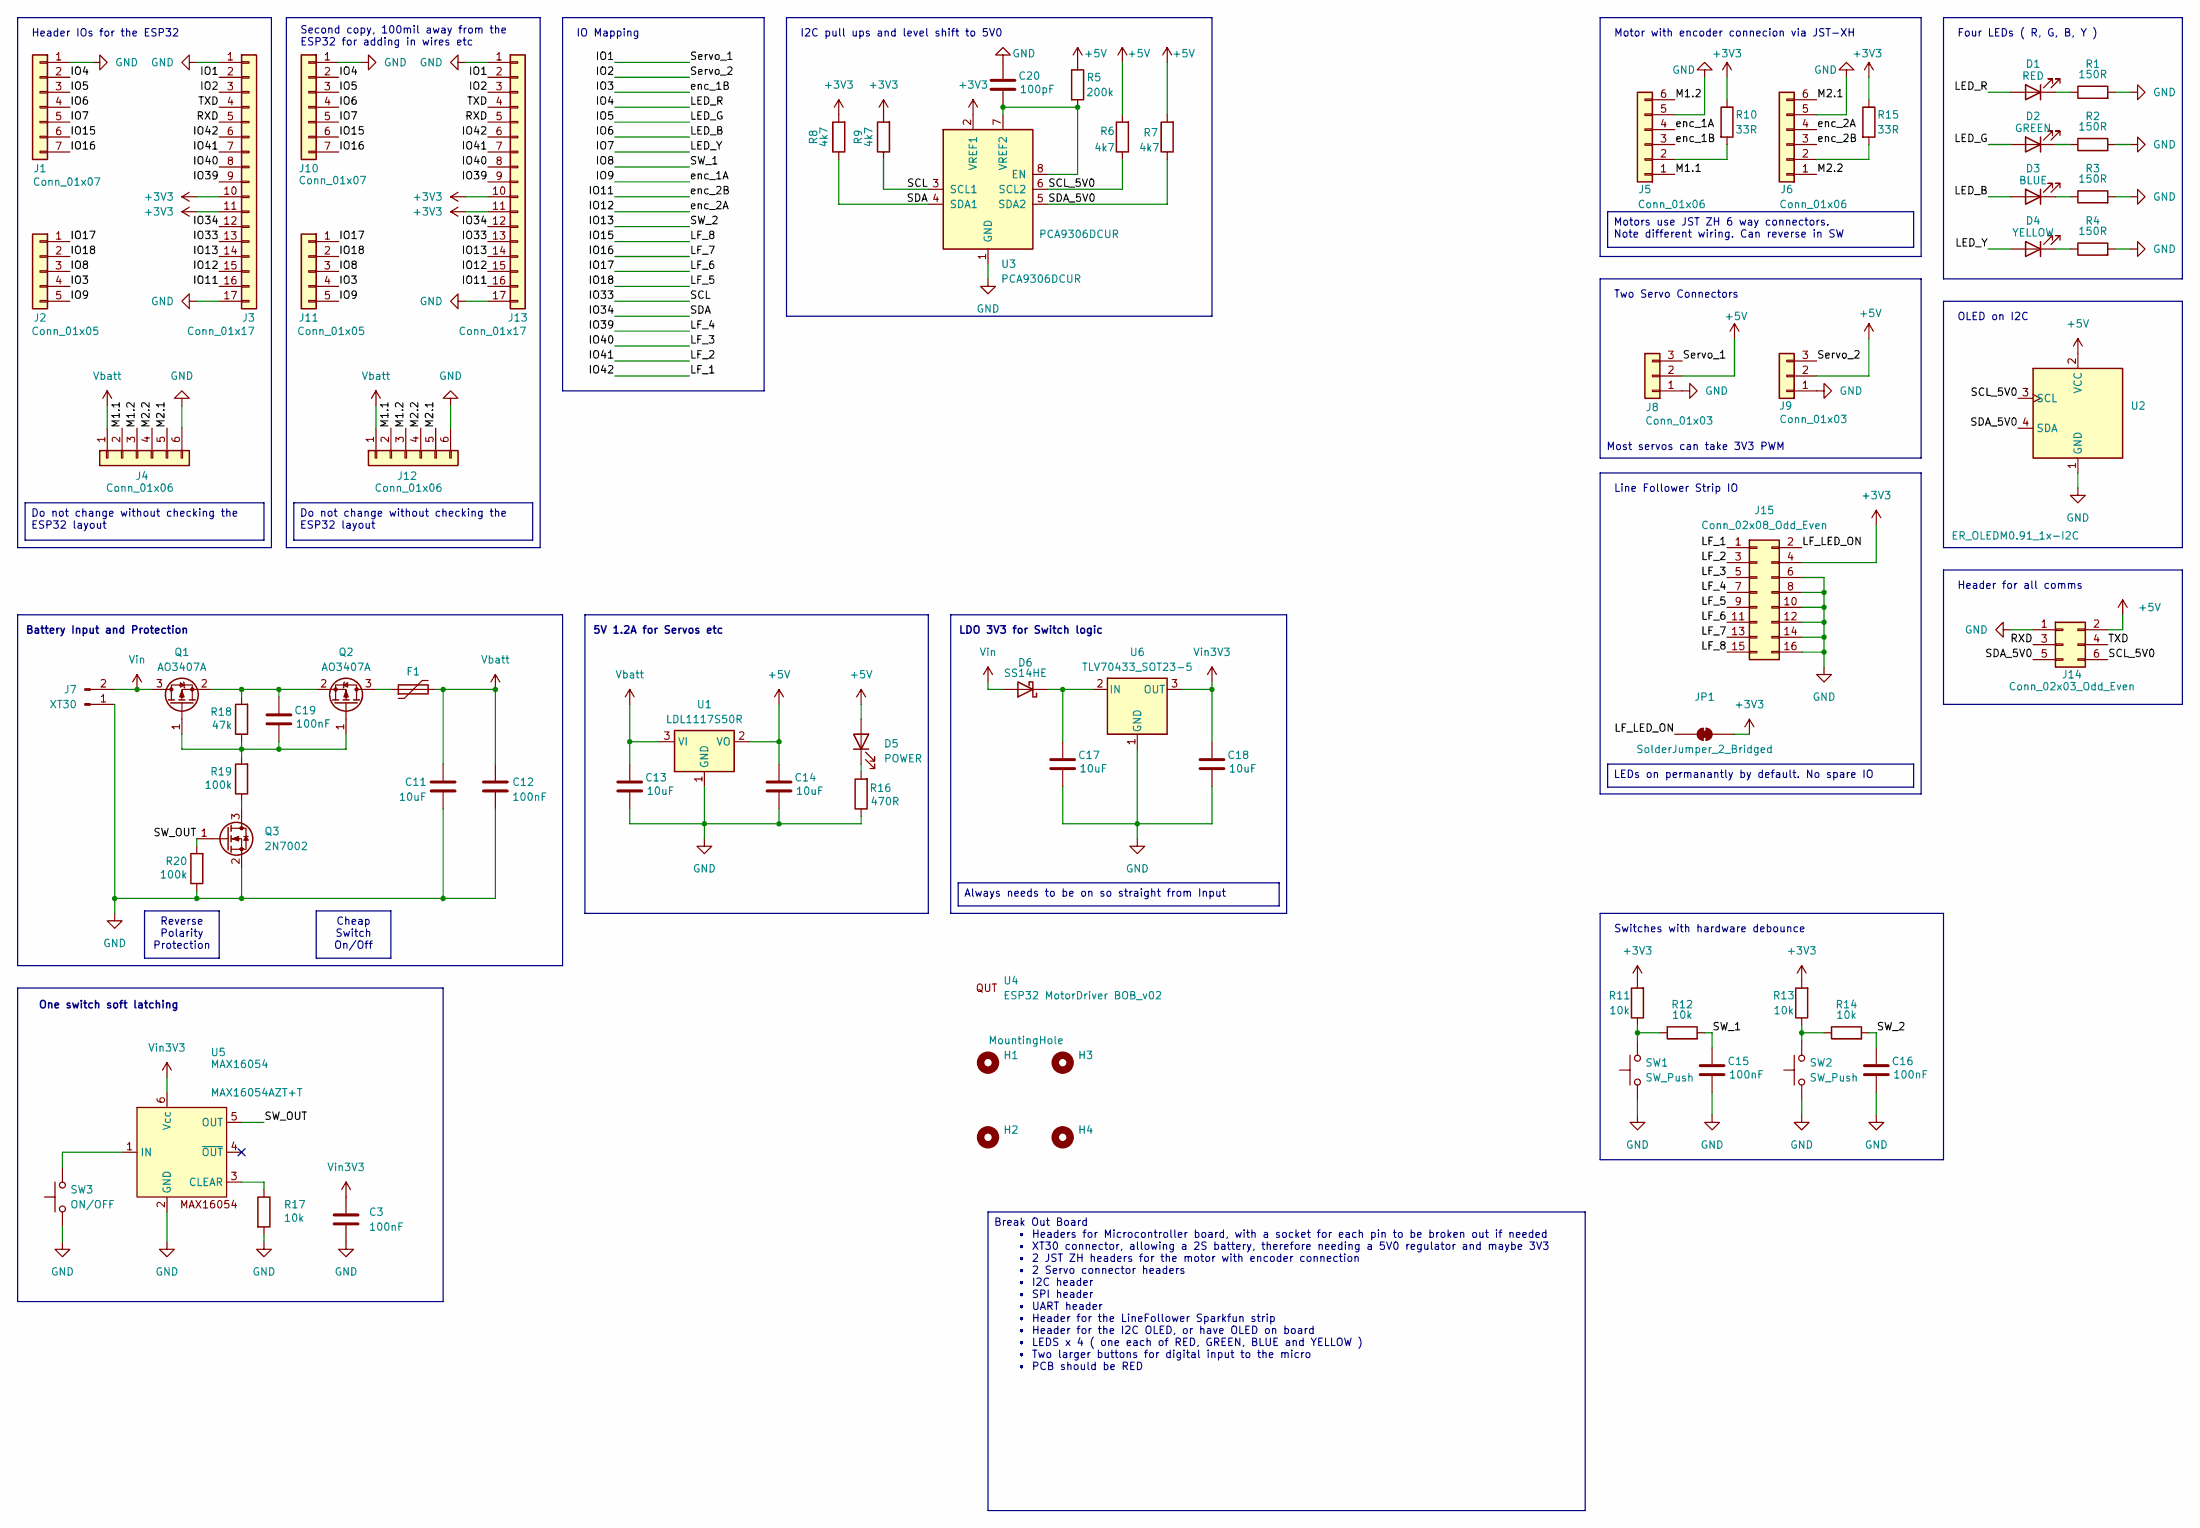
[picture p8: schematic ESP32_MotorDriver_BOB.kicad_sch]

Parts:
C3, C12, C15, C16, C19: 100nF; C_0402_1005Metric_Pad0.74x0.62mm_HandSolder
C11, C13, C14, C17, C18: 10uF; C_0805_2012Metric_Pad1.18x1.45mm_HandSolder
C20: 100pF; C_0402_1005Metric_Pad0.74x0.62mm_HandSolder
D1: RED; LED_1206_3216Metric_Pad1.42x1.75mm_HandSolder
D2: GREEN; LED_1206_3216Metric_Pad1.42x1.75mm_HandSolder
D3: BLUE; LED_1206_3216Metric_Pad1.42x1.75mm_HandSolder
D4: YELLOW; LED_1206_3216Metric_Pad1.42x1.75mm_HandSolder
D5: POWER; LED_0805_2012Metric_Pad1.15x1.40mm_HandSolder
D6: SS14HE; D_SOD-323HE_SS14HE
F1: PTC RESET FUSE 16V 2.5A 1812; Fuse_1812_4532Metric_Pad1.30x3.40mm_HandSolder
H1, H2, H3, H4: MountingHole; MountingHole_3.2mm_M3
J1, J10: Conn_01x07; PinSocket_1x07_P2.54mm_Vertical
J2, J11: Conn_01x05; PinSocket_1x05_P2.54mm_Vertical
J3, J13: Conn_01x17; PinSocket_1x17_P2.54mm_Vertical
J4, J12: Conn_01x06; PinSocket_1x06_P2.54mm_Vertical
J5, J6: Conn_01x06; JST_ZH_S6B-ZR-SM4A-TF_1x06-1MP_P1.50mm_Horizontal
J7: XT30; AMASS_XT30PW-M_1x02_P2.50mm_Horizontal
J8, J9: Conn_01x03; PinHeader_1x03_P2.54mm_Vertical
J14: Conn_02x03_Odd_Even; PinHeader_2x03_P2.54mm_Vertical
J15: Conn_02x08_Odd_Even; PinHeader_2x08_P2.54mm_Vertical
JP1: SolderJumper_2_Bridged; SolderJumper-2_P1.3mm_Bridged_RoundedPad1.0x1.5mm
Q1, Q2: AO3407A; SOT-23
Q3: 2N7002; SOT-23
R1, R2, R3, R4: 150R; R_0402_1005Metric_Pad0.72x0.64mm_HandSolder
R5: 200k; R_0402_1005Metric_Pad0.72x0.64mm_HandSolder
R6, R7, R8, R9: 4k7; R_0402_1005Metric_Pad0.72x0.64mm_HandSolder
R10, R15: 33R; R_0402_1005Metric_Pad0.72x0.64mm_HandSolder
R11, R12, R13, R14, R17: 10k; R_0402_1005Metric_Pad0.72x0.64mm_HandSolder
R16: 470R; R_0402_1005Metric_Pad0.72x0.64mm_HandSolder
R18: 47k; R_0402_1005Metric_Pad0.72x0.64mm_HandSolder
R19, R20: 100k; R_0402_1005Metric_Pad0.72x0.64mm_HandSolder
SW1, SW2: SW_Push; SW_SPST_EVQP0
SW3: ON/OFF; SW_SPST_EVQP0
U1: LDL1117S50R; SOT-223-3_TabPin2
U2: ER_OLEDM0.91_1x-I2C
U3: PCA9306DCUR; VSSOP-8_3x3mm_P0.65mm
U4: ESP32 MotorDriver BOB_v02; logo_QUT
U5: MAX16054; SOT-23-6
U6: TLV70433_SOT23-5; SOT-23-5

Connections:
+3V3: J3.10, J3.11, J13.10, J13.11, J15.4, JP1.2 (B), R8.2, R9.2, R10.1, R11.2, R13.2, R15.1, U3.2 (VREF1)
+5V: C14.1, D5.2 (A), J8.2, J9.2, J14.2, R5.1, R6.2, R7.2, U1.2 (VO), U2.2 (VCC)
/IO1: J3.2, J8.3, J13.2
/IO2: J3.3, J9.3, J13.3
/IO3: J2.4, J5.3, J11.4
/IO4: D1.2 (A), J1.2, J10.2
/IO5: D2.2 (A), J1.3, J10.3
/IO6: D3.2 (A), J1.4, J10.4
/IO7: D4.2 (A), J1.5, J10.5
/IO8: C15.1, J2.3, J11.3, R12.2
/IO9: J2.5, J5.4, J11.5
/IO11: J3.16, J6.3, J13.16
/IO12: J3.15, J6.4, J13.15
/IO13: C16.1, J3.14, J13.14, R14.2
/IO15: J1.6, J10.6, J15.15
/IO16: J1.7, J10.7, J15.13
/IO17: J2.1, J11.1, J15.11
/IO18: J2.2, J11.2, J15.9
/IO33: J3.13, J13.13, R9.1, U3.3 (SCL1)
/IO34: J3.12, J13.12, R8.1, U3.4 (SDA1)
/IO39: J3.9, J13.9, J15.7
/IO40: J3.8, J13.8, J15.5
/IO41: J3.7, J13.7, J15.3
/IO42: J3.6, J13.6, J15.1
/LF_LED_ON: J15.2, JP1.1 (A)
/M1.1: J4.2, J5.1, J12.2
/M1.2: J4.3, J5.6, J12.3
/M2.1: J4.5, J6.6, J12.5
/M2.2: J4.4, J6.1, J12.4
/RXD: J3.5, J13.5, J14.3
/SCL_5V0: J14.6, R6.1, U2.3 (SCL), U3.6 (SCL2)
/SDA_5V0: J14.5, R7.1, U2.4 (SDA), U3.5 (SDA2)
/SW_OUT: Q3.1 (G), R20.2, U5.5 (OUT)
/TXD: J3.4, J13.4, J14.4
GND: C3.2, C11.2, C12.2, C13.2, C14.2, C15.2, C16.2, C17.2, C18.2, C20.1, J1.1, J3.1, J3.17, J4.6, J5.5, J6.5, J7.1, J8.1, J9.1, J10.1, J12.6, J13.1, J13.17, J14.1, J15.6, J15.8, J15.10, J15.12, J15.14, J15.16, Q3.2 (S), R1.2, R2.2, R3.2, R4.2, R16.1, R17.2, R20.1, SW1.1, SW2.1, SW3.1, U1.1 (GND), U2.1 (GND), U3.1 (GND), U5.2 (GND), U6.1 (GND)
unnamed: D1.1 (K), R1.1
unnamed: D2.1 (K), R2.1
unnamed: D3.1 (K), R3.1
unnamed: D4.1 (K), R4.1
unnamed: D5.1 (K), R16.2
unnamed: C17.1, D6.1 (K), U6.2 (IN)
unnamed: J5.2, R10.2
unnamed: J6.2, R15.2
unnamed: C19.2, Q1.1 (G), Q2.1 (G), R18.1, R19.2
unnamed: C19.1, Q1.2 (S), Q2.2 (S), R18.2
unnamed: F1.1, Q2.3 (D)
unnamed: Q3.3 (D), R19.1
unnamed: R11.1, R12.1, SW1.2
unnamed: R13.1, R14.1, SW2.2
unnamed: C20.2, R5.2, U3.7 (VREF2), U3.8 (EN)
unnamed: R17.1, U5.3 (CLEAR)
unnamed: SW3.2, U5.1 (IN)
Vbatt: C11.1, C12.1, C13.1, F1.2, J4.1, J12.1, U1.3 (VI)
Vin: D6.2 (A), J7.2, Q1.3 (D)
Vin3V3: C3.1, C18.1, U5.6 (Vcc), U6.3 (OUT)

Notes on the sheet:
Line Follower Strip IO
Header IOs for the ESP32
Most servos can take 3V3 PWM
Two Servo Connectors
Battery Input and Protection
Switches with hardware debounce
5V 1.2A for Servos etc
OLED on I2C
LDO 3V3 for Switch logic
Second copy, 100mil away from the ESP32 for adding in wires etc
Motor with encoder connecion via JST-XH
Four LEDs ( R, G, B, Y )
Header for all comms
One switch soft latching
IO Mapping
I2C pull ups and level shift to 5V0
Cheap Switch On/Off
Break Out Board • Headers for Microcontroller board, with a socket for each pin to be broken out if needed • XT30 connector, allowing a 2S battery, therefore needing a 5V0 regulator and maybe 3V3 • 2 JST ZH headers for the motor with encoder connection • 2 Servo connector headers • I2C header • SPI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
Do not change without checking the ESP32 layout
LEDs on permanantly by default. No spare IO
Reverse Polarity Protection
Always needs to be on so straight from Input
Motors use JST ZH 6 way connectors. Note different wiring. Can reverse in SW

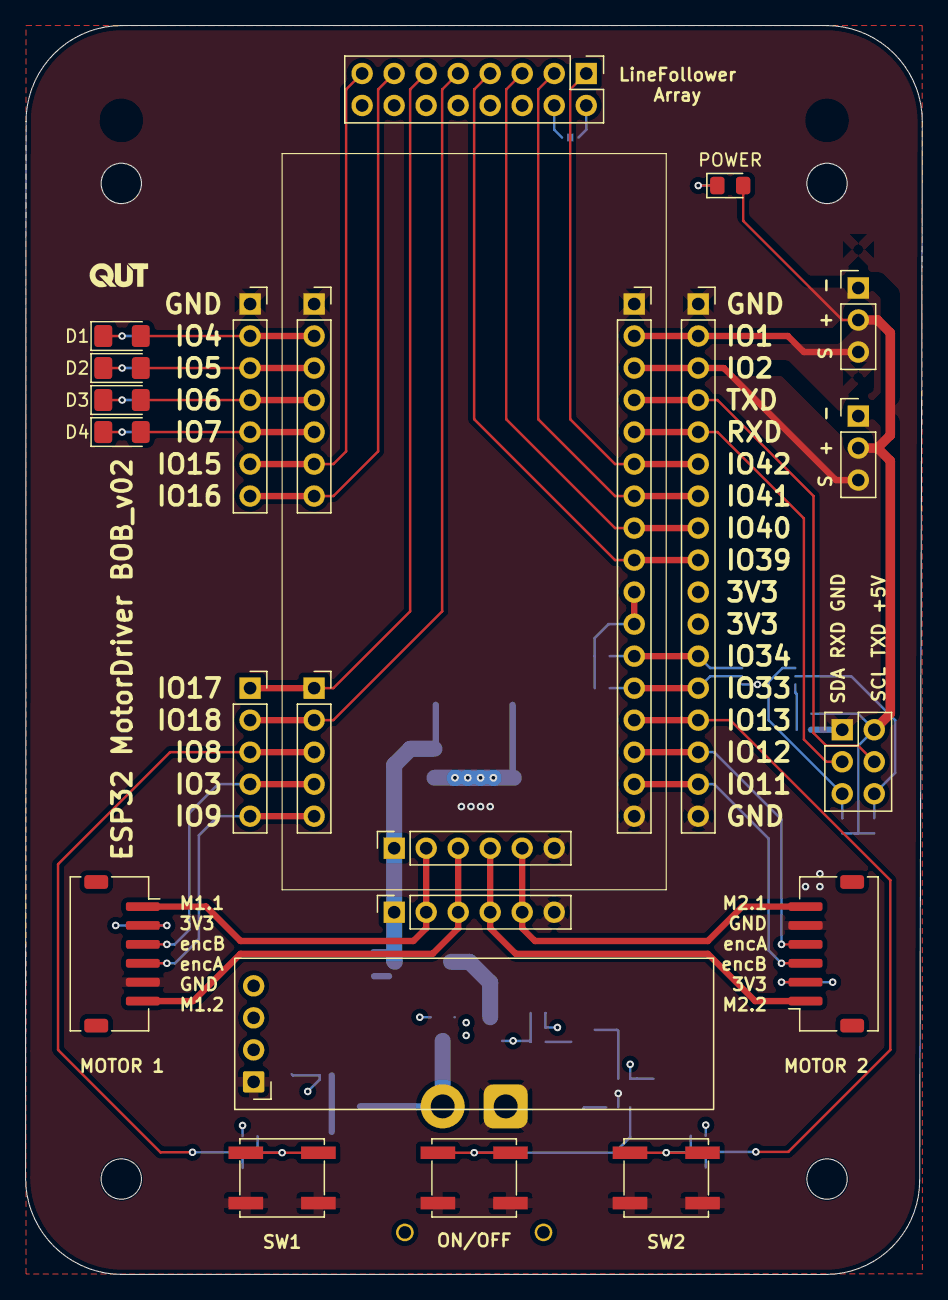
[picture p9: board ESP32_MotorDriver_BOB.kicad_pcb from above]

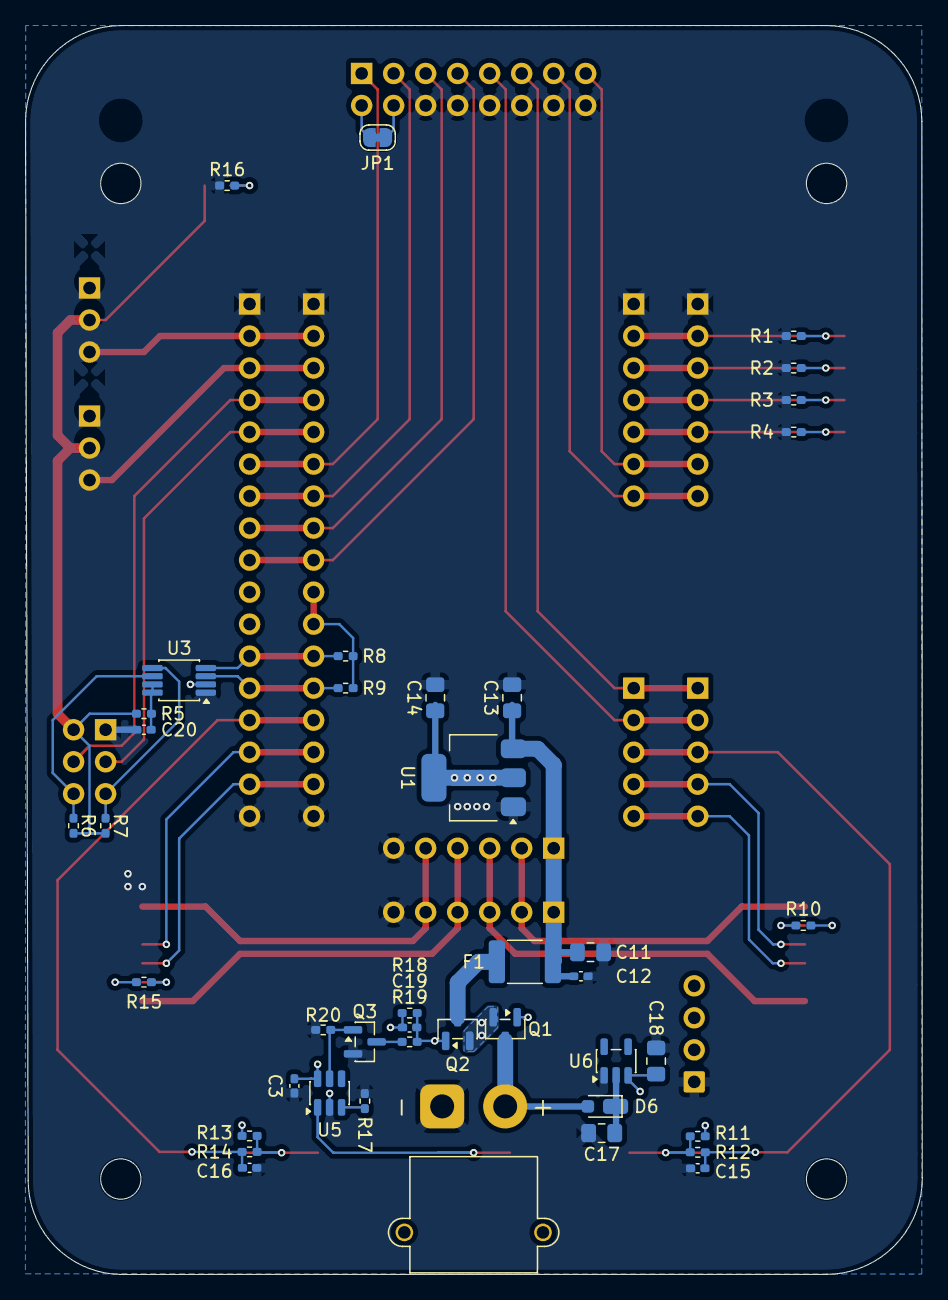
[picture p10: board ESP32_MotorDriver_BOB.kicad_pcb from below]

Board: 4 copper layers, 71.2 x 99.1 mm, 70 parts (42 on the bottom side), 55 nets.
