QUTstevenbulmer/Unit_EGB220/(commit log)

2026-10-09 _v01
    Into manufacturing. Lets see what happens
    [ESP32_MotorDriver.kicad_pcb, ESP32_MotorDriver.kicad_sch, ESP32_MotorDriver_BOB.kicad_pcb, ESP32_MotorDriver_BOB.kicad_sch]
2026-10-09 actual _v01
    Issue with files being copied - these should be good
    [ESP32_MotorDriver.kicad_pcb, ESP32_MotorDriver.kicad_sch, ESP32_MotorDriver_BOB.kicad_pcb, ESP32_MotorDriver_BOB.kicad_sch]
2026-10-12 _v01 changes to include BOMs and CSV files
    [Build_2027.xlsx, ESP32_MotorDriver.csv, ESP32_MotorDriver.kicad_pcb_bom.csv, ESP32_MotorDriver.kicad_pcb_positions.csv, ESP32_MotorDriver_BOB.kicad_pcb_bom.csv, ESP32_MotorDriver_BOB.kicad_pcb_positions.csv, bom.csv, designators.csv]
2026-10-20 Initial Software
    Hotspot if no WIFI, then allows users to connect to a home or enterprise WIFI. Have checked LEDs and a motor. So far so good
    [esp32s2_motordriver.json]
2026-10-28 BOB v02
    Submitted for manufacturer with a few minor fixes from v01. 3V3 to LineFollower array, New footprint for Motor connections and a switch added for power on/off
    [Build_2027.xlsx, ESP32_MotorDriver.kicad_pcb, ESP32_MotorDriver.kicad_sch, ESP32_MotorDriver_BOB.csv, ESP32_MotorDriver_BOB.kicad_pcb, ESP32_MotorDriver_BOB.kicad_pcb_bom.csv, ESP32_MotorDriver_BOB.kicad_pcb_positions.csv, ESP32_MotorDriver_BOB.kicad_sch]
2026-10-28 Software to v1.80
    5 WIFI points added, Drive page with Jog wheel
    [esp32s2_motordriver.json]
